rulir/IR_Thermometer_Evaluation_Board-MLX90614/Firmware/README.md

SparkFun MLX90614 Firmware
===================================

* **IR_eval** - AVR example
* **MLX90614** - Arduino simple sketch example
