rulir/IR_Thermometer_Evaluation_Board-MLX90614/Hardware/SparkFun_IR_Thermometer_Eval-MLX90614.brd

## EAGLE design Hardware/SparkFun_IR_Thermometer_Eval-MLX90614.brd (2015-05-07)

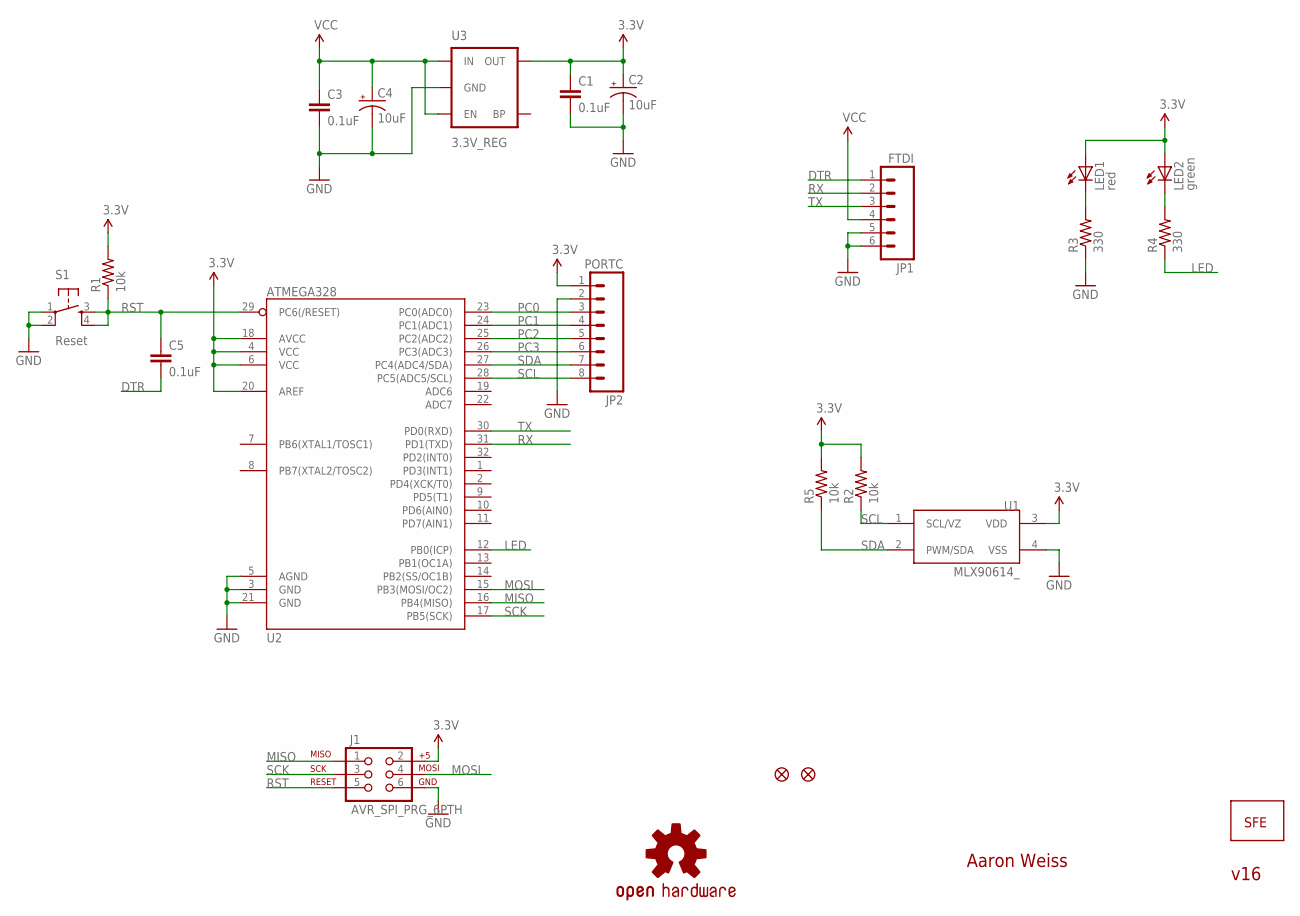
[picture p1: schematic SparkFun_IR_Thermometer_Eval-MLX90614.sch]

Parts:
C1, C3, C5: 0.1uF; 0402-CAP
C2, C4: 10uF; EIA3216
J1: AVR_SPI_PRG_6PTH; 2X3
JP1: FTDI; 1X06
JP2: PORTC; 1X08
JP3, JP5: FIDUCIAL1X2.5; FIDUCIAL-1X2.5
JP4: LOGO-SFESK; SFE-LOGO-FLAME
LED1: red; LED-0603
LED2: green; LED-0603
R1, R2, R5: 10k; 0402-RES
R3, R4: 330; 0402-RES
S1: Reset; TACTILE_SWITCH_SMD
U1: MLX90614_; TO-39
U2: ATMEGA328; TQFP32-08
U3: 3.3V_REG; SOT23-5
U$1: OSHW-LOGOS; OSHW-LOGO-S

Connections:
3.3V: C1.1, C2.A (+), J1.2, JP2.1, LED1.A, LED2.A, R1.2, R2.2, R5.2, U1.3 (VDD), U2.4 (VCC), U2.6 (VCC), U2.18 (AVCC), U2.20 (AREF), U3.5 (OUT)
DTR: C5.2, JP1.1
GND: C1.2, C2.C (-), C3.2, C4.C (-), J1.6, JP1.5, JP1.6, JP2.2, R3.1, S1.1, S1.2, U1.4 (VSS), U2.3 (GND), U2.5 (AGND), U2.21 (GND), U3.2 (GND)
LED: R4.1, U2.12 (PB0(ICP))
MISO: J1.1, U2.16 (PB4(MISO))
MOSI: J1.4, U2.15 (PB3(MOSI/OC2))
unnamed: LED1.C, R3.2
unnamed: LED2.C, R4.2
PC0: JP2.3, U2.23 (PC0(ADC0))
PC1: JP2.4, U2.24 (PC1(ADC1))
PC2: JP2.5, U2.25 (PC2(ADC2))
PC3: JP2.6, U2.26 (PC3(ADC3))
RST: C5.1, J1.5, R1.1, S1.3, S1.4, U2.29 (PC6(/RESET))
RX: JP1.2, U2.31 (PD1(TXD))
SCK: J1.3, U2.17 (PB5(SCK))
SCL: JP2.8, R2.1, U1.1 (SCL/VZ), U2.28 (PC5(ADC5/SCL))
SDA: JP2.7, R5.1, U1.2 (PWM/SDA), U2.27 (PC4(ADC4/SDA))
TX: JP1.3, U2.30 (PD0(RXD))
VCC: C3.1, C4.A (+), JP1.4, U3.1 (IN), U3.3 (EN)

Notes on the sheet:
v16
Aaron Weiss

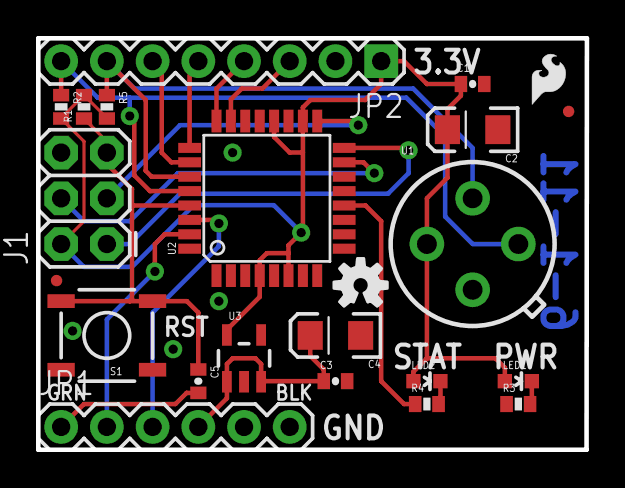
[picture p2: board SparkFun_IR_Thermometer_Eval-MLX90614.brd from above]

Board: 2 copper layers, 30.5 x 22.9 mm, 23 parts (0 on the bottom side), 19 nets.
