rulir/IR_Thermometer_Evaluation_Board-MLX90614/(commit log)

2015-05-07 Adding hardware, simple sketch, modifying original code format
    [SparkFun_IR_Thermometer_Eval-MLX90614.brd, SparkFun_IR_Thermometer_Eval-MLX90614.sch]
2015-10-29 Squashed 'Libraries/Arduino/' content from commit 685d598
    git-subtree-dir: Libraries/Arduino
    git-subtree-split: 685d5982f8ea6b3f40d49d6d1de3f3648623114a
